marianobustos/Librerias-Kicad/README.md

# Librerias-Kicad
Librerías para Kicad realizadas en la E.E.S.T. N°5
