marianobustos/Librerias-Kicad/(commit log)

2017-06-09 Componentes varios
    Se comenzó a actualizar la libreria en el ciclo lectivo 2017.
    La mayoria de los componentes fueron actualizados con sus modelos 3D
    tanto en formato STEP como WRL, para ser compatible con el plugin
    KICAD-STEP-UP.
2017-09-18 Varios
    Actualización de algunos componentes, mayormente se generó el modelo
    .step desde freecad para la correcta visualización mediante el plugin
    STEP UP
2020-10-19 Global update
    Actualización global luego de utilizar otros metodos de versionado.
2020-11-09 Opto-triac + CAN bus
    Se agregaron los siguientes componentes:
    DB3 (Diac)
    TIC226
    MOC3021
    MCP2515
    MCP2551
    TJA1050
2020-11-10 Bluepill (STM32F103C8T6)
    Agregué el SCH, Footprint y modelo 3D desde la libreria:
    https://github.com/yet-another-average-joe/Kicad-STM32
2020-12-12 ESP32 S2
    Agrego el integrado de referencia
2020-12-14 Teensy & Rueda velocista
    Agregue una nueva version de la teensy en donde los pines posteriores no son conectados al pcb.
    Agregué el modelo 3D de una rueda de velocista con motor pololu y soporte simple.
2020-12-14 Display Oled i2c
    Agregué tanto el simbolo de SCH como el footprint y el correspondiente modelo 3D de la pantalla Oled de 128x64 con interfaz i2c
2020-12-16 Rueda velocista y Bateria Lipo
    Actualización del footprint y los modelos 3D de ambos componentes.
2021-05-30 Actualización grupal
    Se agregó el símbolo FAN3121T entre otras actualizaciones.
2021-05-30 Actualización FAN3121T
    Se agregan las líneas graficas al símbolo para visualizar que las salidas son negadas
2022-05-12 Nuevos simbolos y footprints
    Agrego simbolos de:
    ESP32-DOIT
    HC-SR04
    MAX31820
    Footprint de:
    Amplicador y Soic-24 (incluyendo modelo 3D)
2022-05-20 ESP32 DOIT DEVKIT V1
    Agrego footprint de referencia
2022-06-26 G2-18V17
    Agrego footprint y modelo 3D del driver de motores para ser utilizado como un conector de 3 pines.
2022-06-30 Migración librería SCH
    Se realiza la migración de la librería de símbolos al nuevo formato a partir de Kicad 6.0.
    Se agregan/actualizan símbolos, footprints y modelos 3D de distintos componentes
2022-07-04 Rpi-Pico
    Agrego símbolo, footprint y modelo 3D de la placa Rpi-Pico RP2040
2022-07-07 2N7000 Update
    Actualizo el símbolo 2N7000
2023-05-25 ARDUINO UNO R2
    Updated symbol & 3D model
2023-08-23 ESP32-WROOM-32E
    Se incluye el footprint del modulo ESP32-WROOM-32E
